lukasznowarkiewicz/HSRGB-enclosure/design files/4th version/assembly_4.FCStd

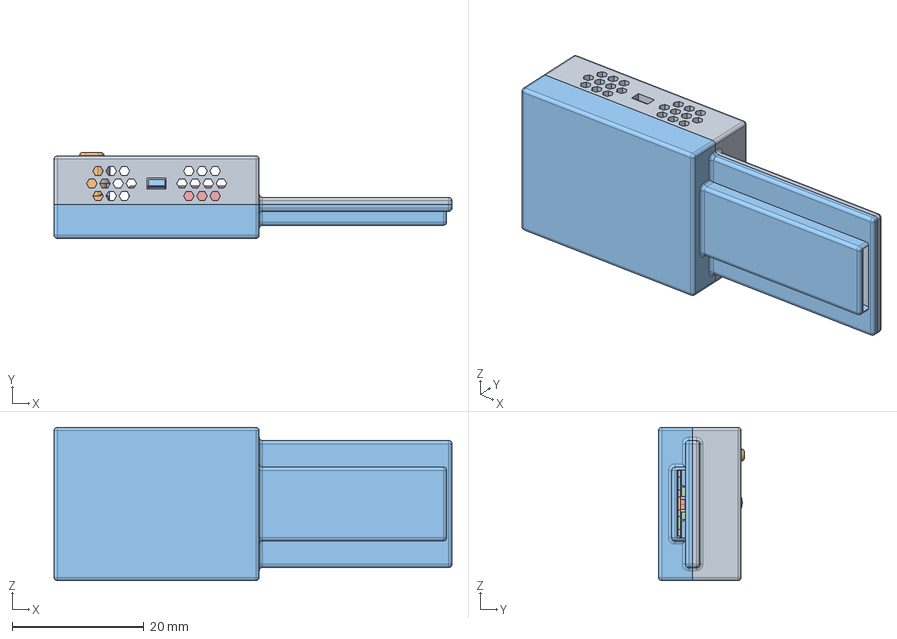
[picture p24: CAD file, 2026-03-15]
design files/4th version/assembly_4.FCStd
60.5 x 13.1 x 23.3 mm
Top_part3
Button3
Bottom_part3
ESP32-C6-WROOM-1-N8
ESP32-C6-WROOM-1-N009
tsop4838_bend
Light
Anode Bottom
Cathode Bottom
Anode
Cathode
Base
C0402
C0403
C0404
SKRPACE010
C0406
C0407
C0408
RES0402
RES0403
RES0404
RES0405
SOT23-3
SOT23-004
SOT23-005
SOT23-006
C0805
C0806
C0807
RES0407
RES0408
RES0409
RES0410
C0809
C0810
C0811
SOT23-008
SOT23-009
SOT23-010
SOT23-011
WS2812_RGB_LED_updated v3
WS2812_RGB_LED_updated v004
C0813
C0814
C0815
RES0412
RES0413
RES0414
RES0415
RES0417
RES0418
RES0419
RES0420
RES0422
RES0423
RES0424
RES0425
RES0427
RES0428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
