lukasznowarkiewicz/HSRGB-enclosure/design files/1st version/Cover (2).STEP

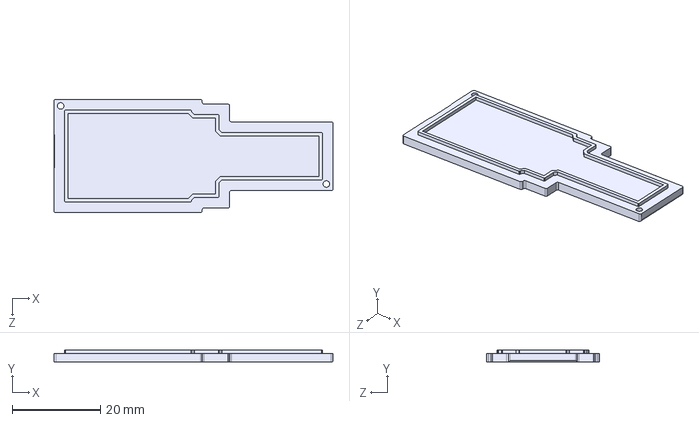
[picture p26: CAD file, 2026-03-15]
design files/1st version/Cover (2).STEP
63.3 x 2.80 x 25.7 mm
