lukasznowarkiewicz/HSRGB-enclosure/design files/2nd version/stl/Top_part1 (1).STL

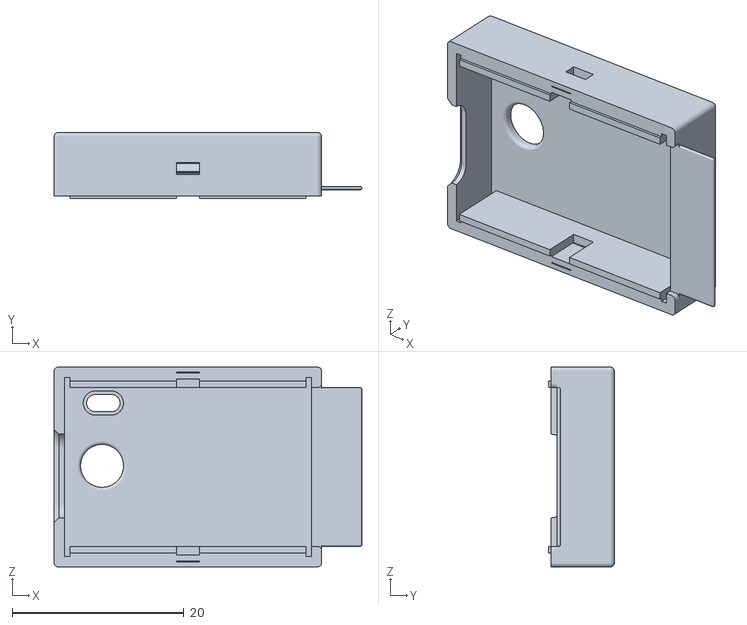
[picture p27: CAD file, 2026-03-15]
design files/2nd version/stl/Top_part1 (1).STL
35.9 x 7.70 x 23.3
