lukasznowarkiewicz/HSRGB-enclosure/design files/3rd version/Button (1).STEP

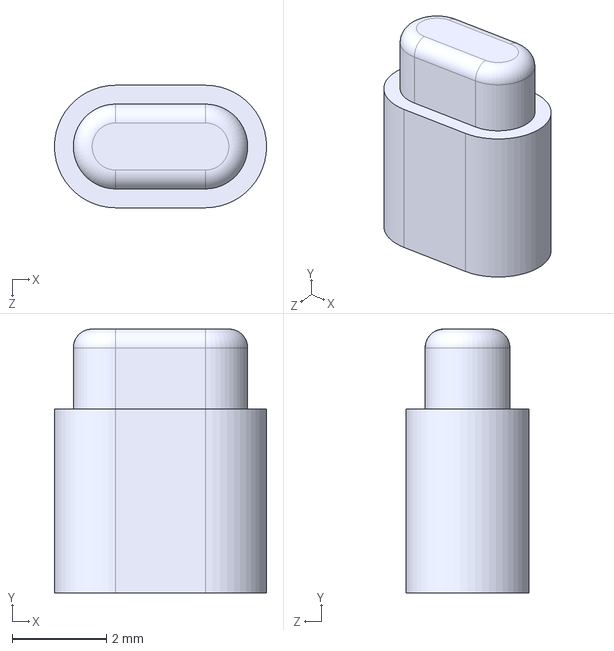
[picture p28: CAD file, 2026-03-15]
design files/3rd version/Button (1).STEP
4.50 x 5.60 x 2.60 mm
