lukasznowarkiewicz/HSRGB-enclosure/design files/5th version/HSRGD2_Casing2 (1).SLDPRT

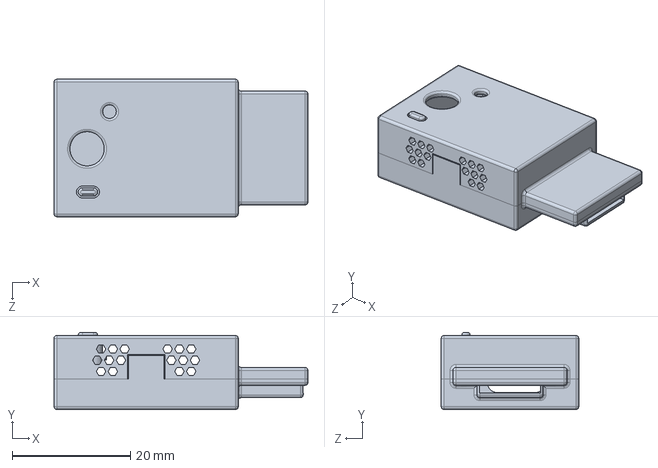
[picture p29: CAD file, 2026-03-15]
design files/5th version/HSRGD2_Casing2 (1).SLDPRT
43.0 x 13.1 x 23.3 mm
