lukasznowarkiewicz/HSRGB-enclosure/quote files/HSRGB2.step

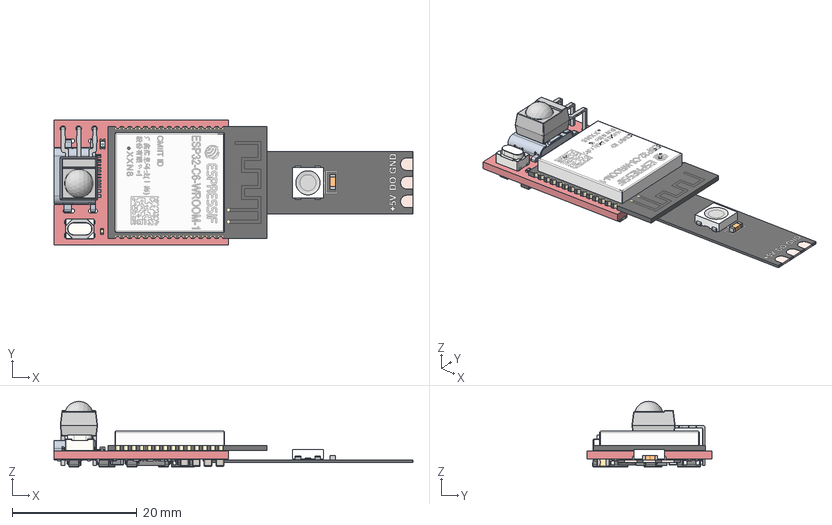
[picture p30: CAD file, 2026-03-15]
quote files/HSRGB2.step
57.7 x 20.1 x 10.5 mm
ESP32-C6-WROOM-1-N8
tsop4838_bend
Light
Anode Bottom
Cathode Bottom
Anode
Cathode
Base
C0402 x 9
SKRPACE010
RES0402 x 19
SOT23-3 x 6
C0805 x 4
WS2812_RGB_LED_updated v3
ferrite_bead_0805 x 2
SOT23-5
CP2102
TSOT-23-6
HSRGB_PCB
