lukasznowarkiewicz/HSRGB-enclosure/design files/1st version/Top_part.STEP

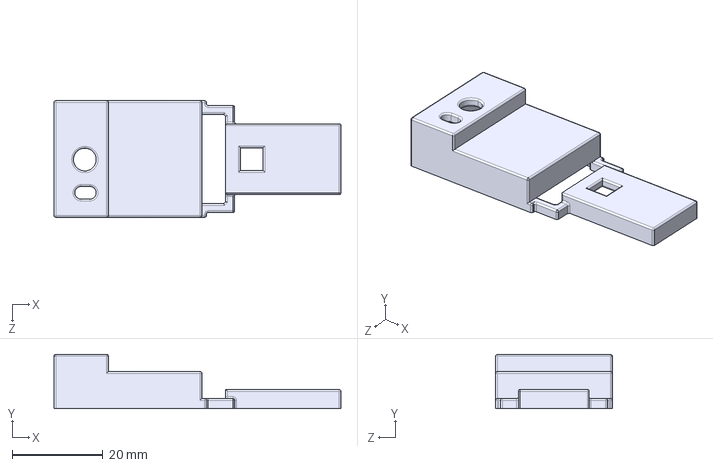
[picture p31: CAD file, 2026-03-15]
design files/1st version/Top_part.STEP
63.3 x 12.0 x 25.7 mm
