lukasznowarkiewicz/HSRGB-enclosure/design files/4th version/Bottom_part3.STEP

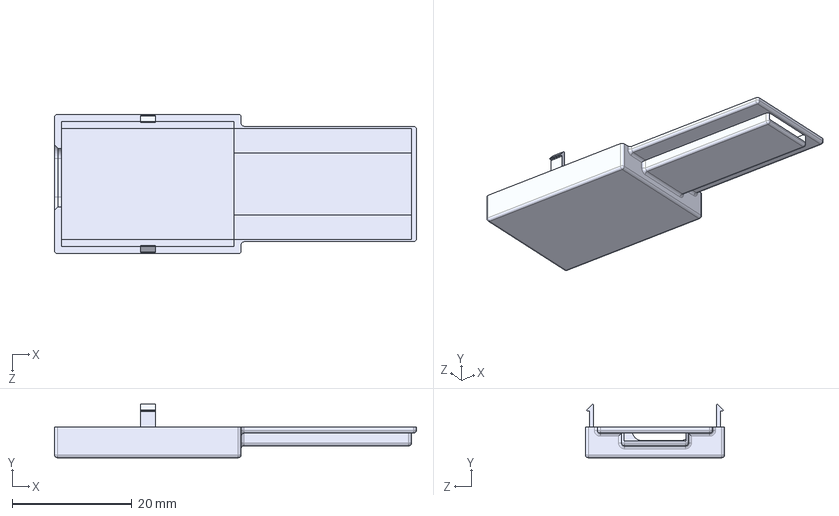
[picture p32: CAD file, 2026-03-15]
design files/4th version/Bottom_part3.STEP
60.5 x 8.95 x 23.3 mm
