lukasznowarkiewicz/HSRGB-enclosure/design files/5th version/Bottom_part4.STEP

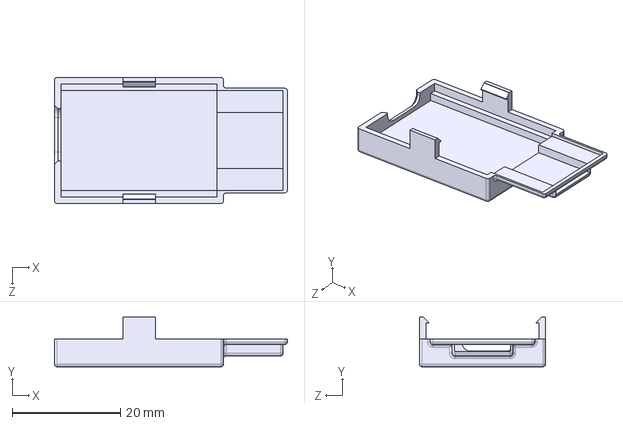
[picture p33: CAD file, 2026-03-15]
design files/5th version/Bottom_part4.STEP
43.0 x 9.15 x 23.3 mm
