lukasznowarkiewicz/HSRGB-enclosure/design files/4th version/Top_part3.STEP

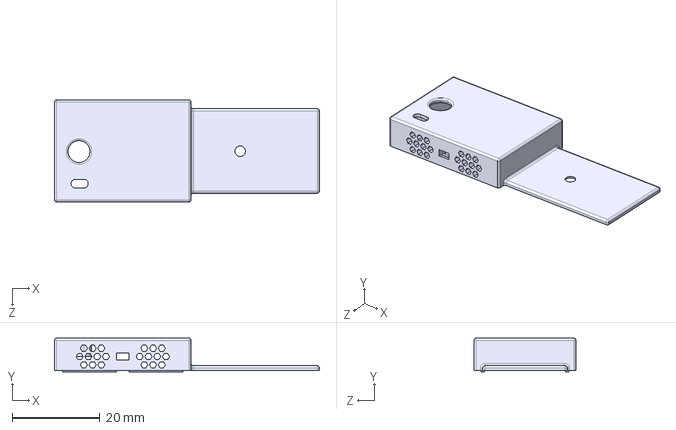
[picture p34: CAD file, 2026-03-15]
design files/4th version/Top_part3.STEP
60.5 x 7.70 x 23.3 mm
