lukasznowarkiewicz/HSRGB-enclosure/design files/5th version/Top_part4.STEP

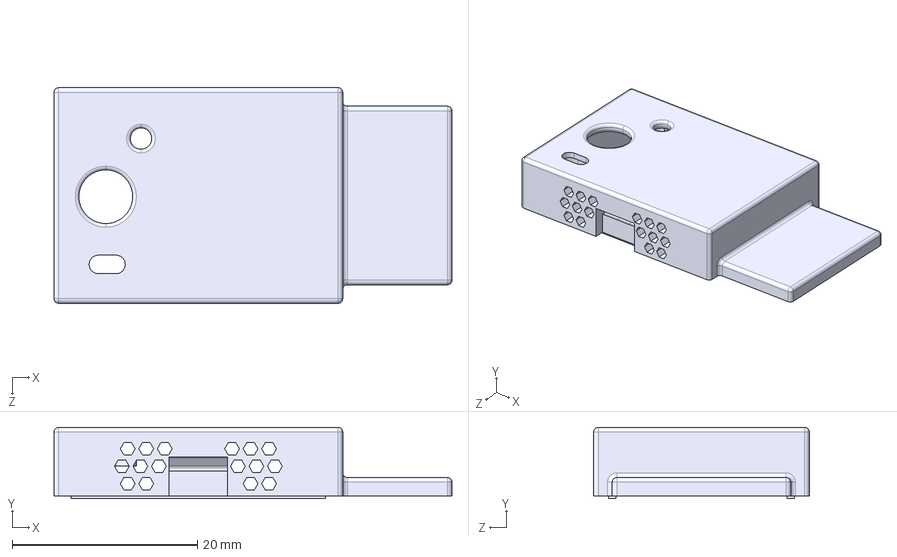
[picture p35: CAD file, 2026-03-15]
design files/5th version/Top_part4.STEP
43.0 x 7.70 x 23.3 mm
