lukasznowarkiewicz/HSRGB-enclosure/design files/2nd version/Bottom_part1.STEP

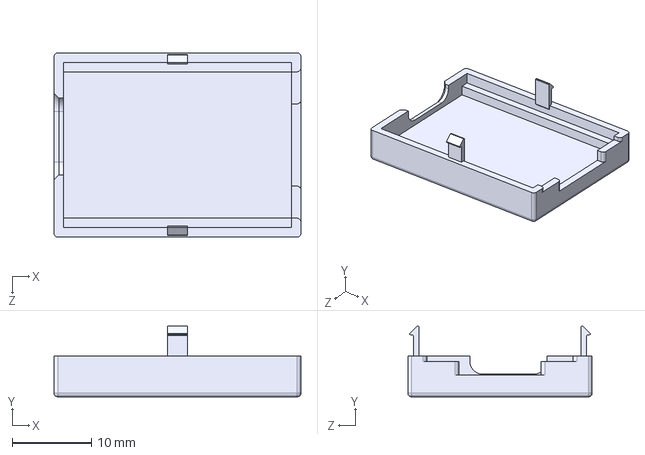
[picture p36: CAD file, 2026-03-15]
design files/2nd version/Bottom_part1.STEP
31.2 x 8.95 x 23.3 mm
