lukasznowarkiewicz/HSRGB-enclosure/design files/5th version/Button4.STEP

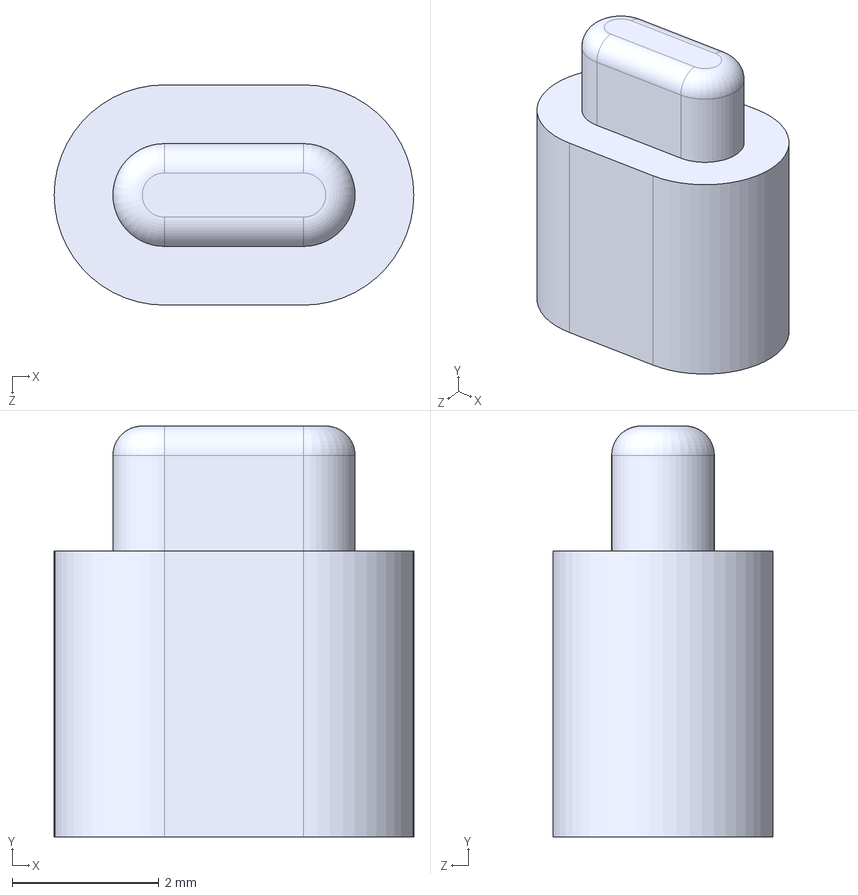
[picture p37: CAD file, 2026-03-15]
design files/5th version/Button4.STEP
4.90 x 5.60 x 3.00 mm
