lukasznowarkiewicz/HSRGB-enclosure/(list of files, cad)

Other CAD files:
design files/3rd version/assembly_3.FCStd
design files/2nd version/Top_part1.STEP
design files/4th version/Button3 (1).STEP
design files/3rd version/Top_part1.STEP
design files/1st version/stl/Cover (2).STL
design files/1st version/stl/Top_part.STL
design files/2nd version/stl/Bottom_part1.STL
design files/2nd version/stl/Button (1).STL
design files/3rd version/stl/Bottom_part1.STL
design files/3rd version/stl/Button (1).STL
design files/4th version/stl/Bottom_part3.STL
design files/4th version/stl/Button3 (1).STL
design files/4th version/stl/Top_part3.STL
design files/5th version/stl/Bottom_part4.STL
design files/5th version/stl/Button4.STL
design files/5th version/stl/Top_part4.STL
